ryood/TS_OD/eagle/TS-OD1_brd.png

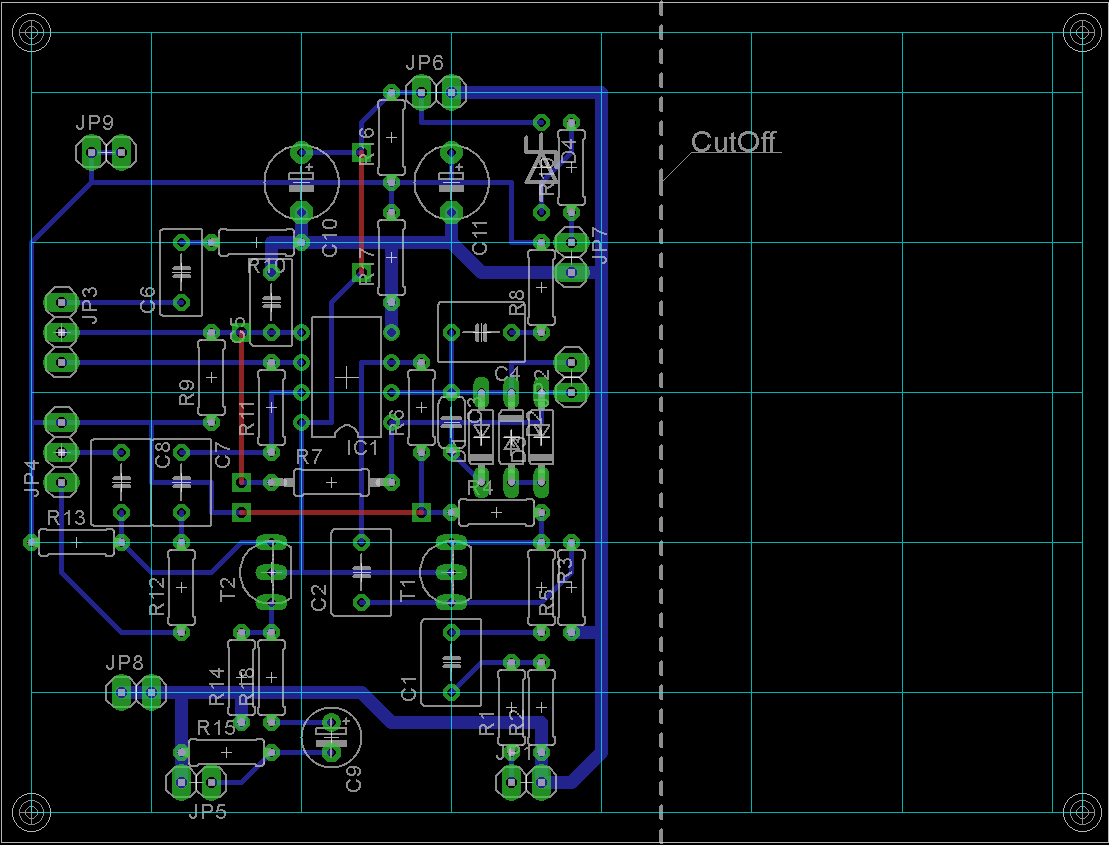
eagle/TS-OD1_brd.png
