ryood/TS_OD/eagle/TS-OD1_sch.png

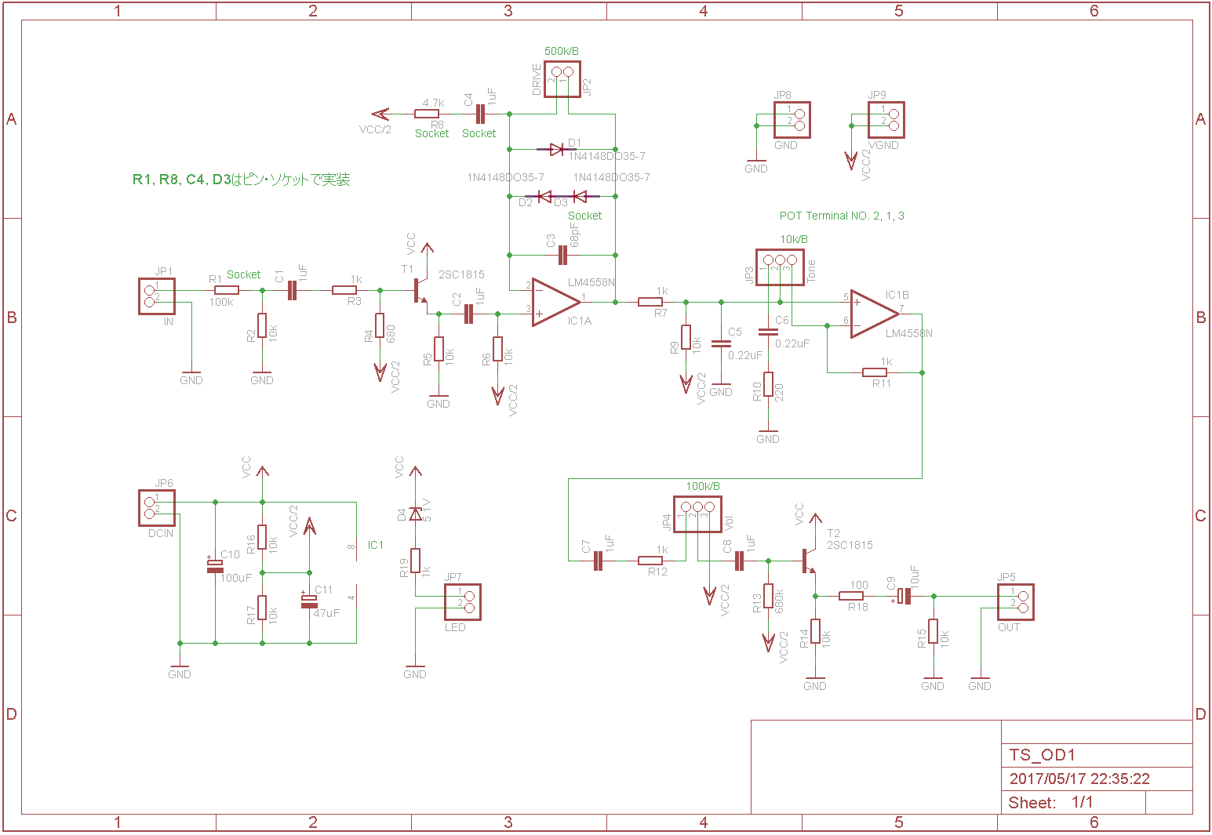
eagle/TS-OD1_sch.png
