ryood/TS_OD/fritzing/TS-OD1ケース内配線_ブレッドボード.png

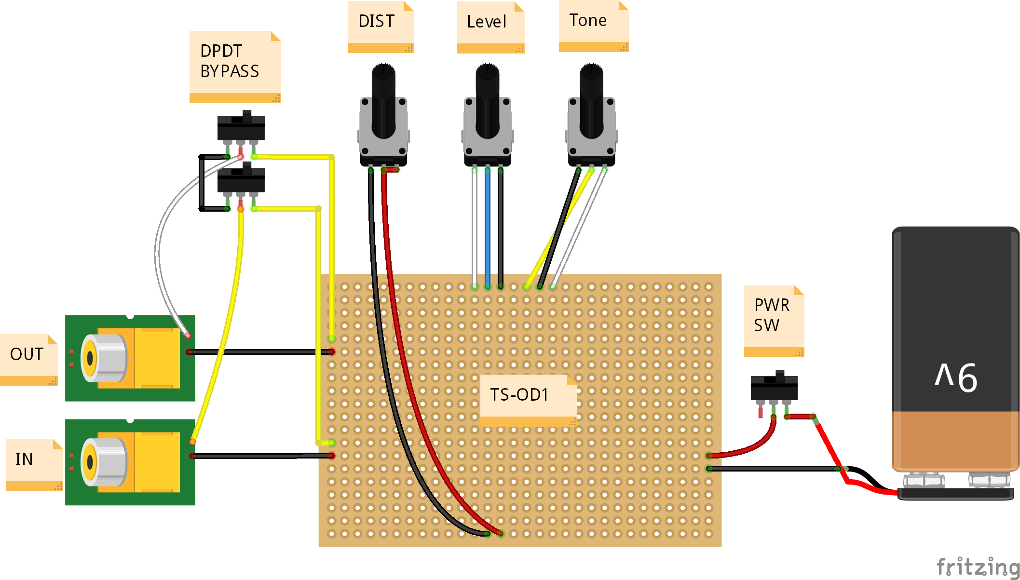
fritzing/TS-OD1ケース内配線_ブレッドボード.png
