ryood/TS_OD/fritzing/Tube_Screamer_Drive_ブレッドボード.png

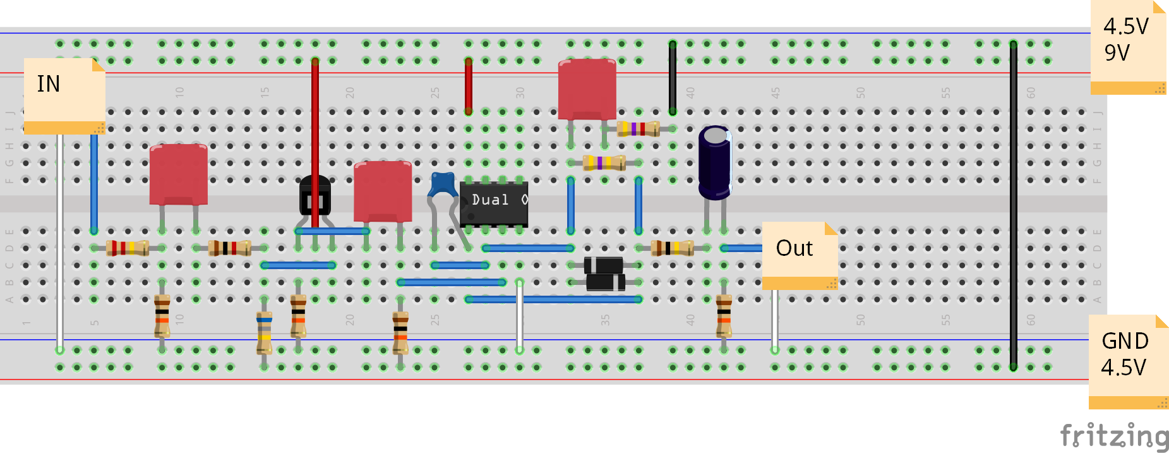
fritzing/Tube_Screamer_Drive_ブレッドボード.png
