ryood/TS_OD/fritzing/Tube_Screamer_Tone_ブレッドボード.png

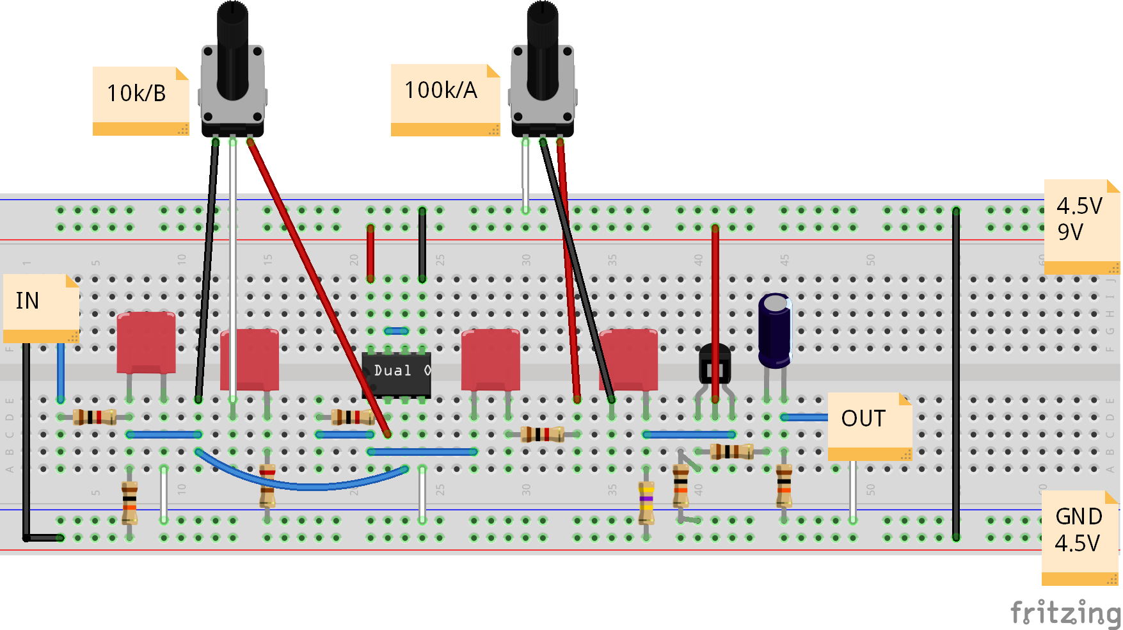
fritzing/Tube_Screamer_Tone_ブレッドボード.png
