ryood/TS_OD/ref/Ibanez_TS-808_cf.GIF

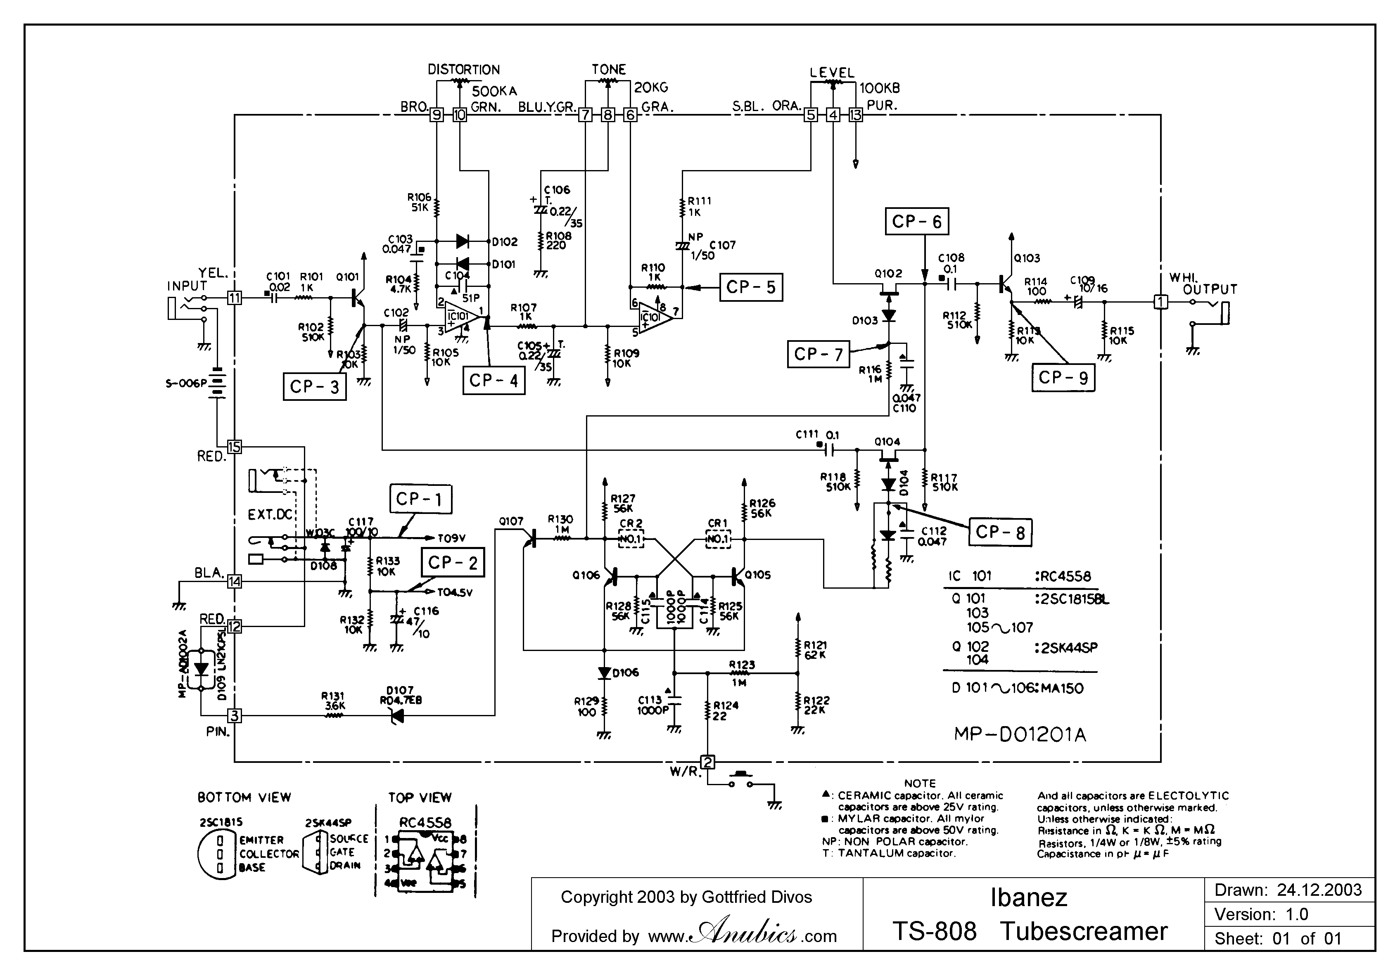
ref/Ibanez_TS-808_cf.GIF
