ryood/TS_OD/ref/OD1PG2.jpg

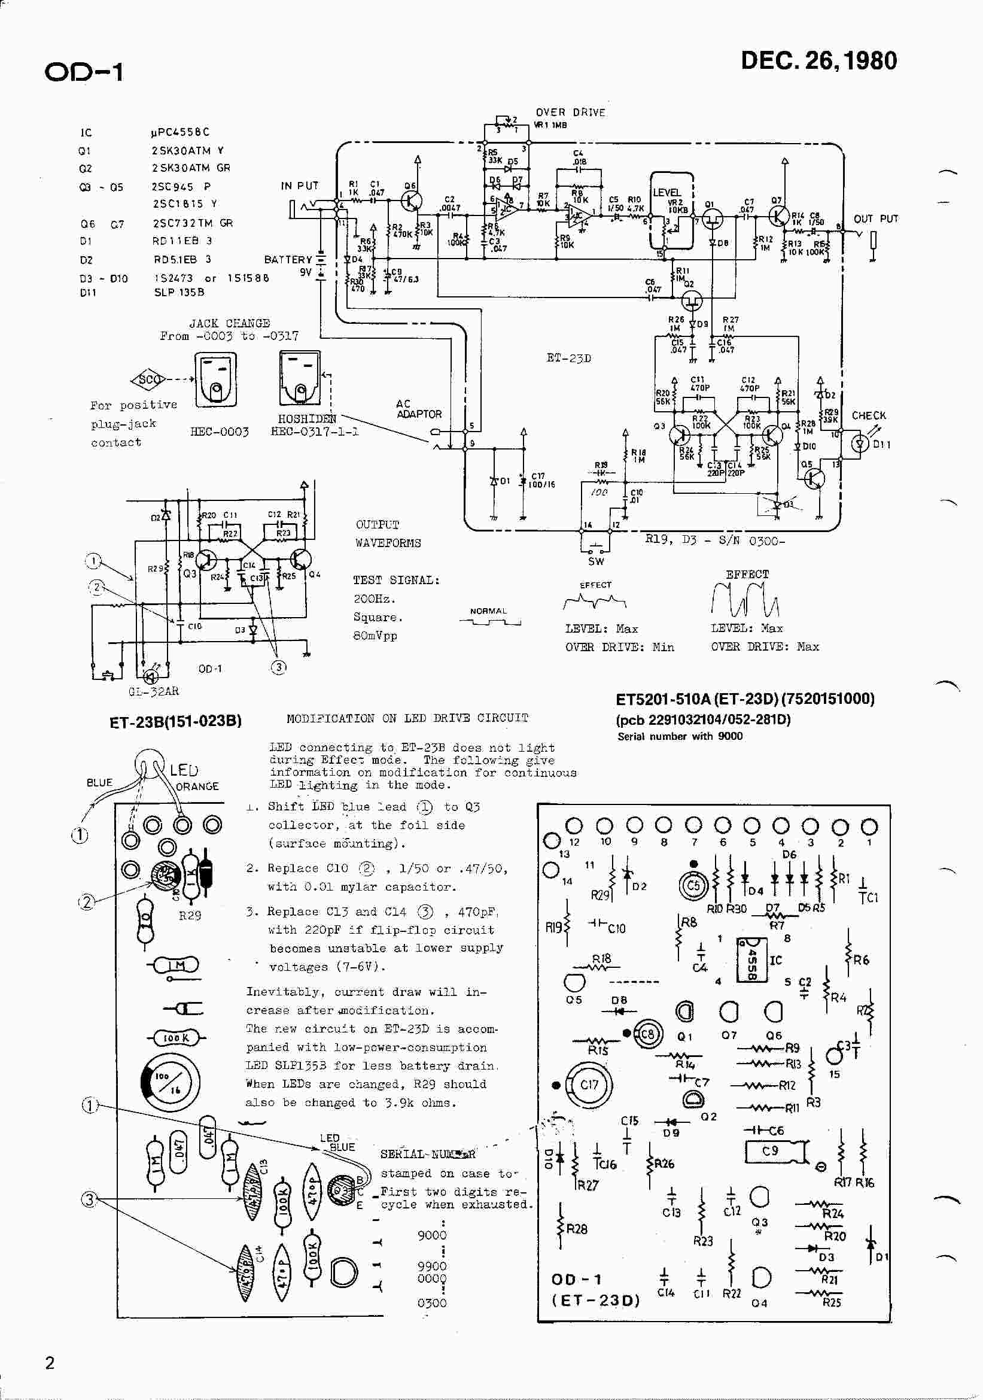
ref/OD1PG2.jpg
