ryood/TS_OD/ref/OD-808_sch.gif

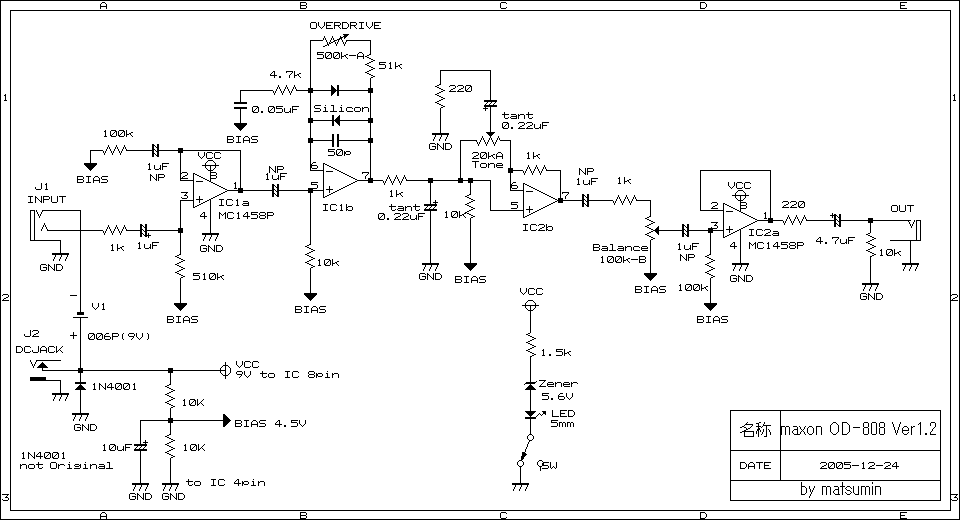
ref/OD-808_sch.gif
