ryood/TS_OD/ref/Rat.gif

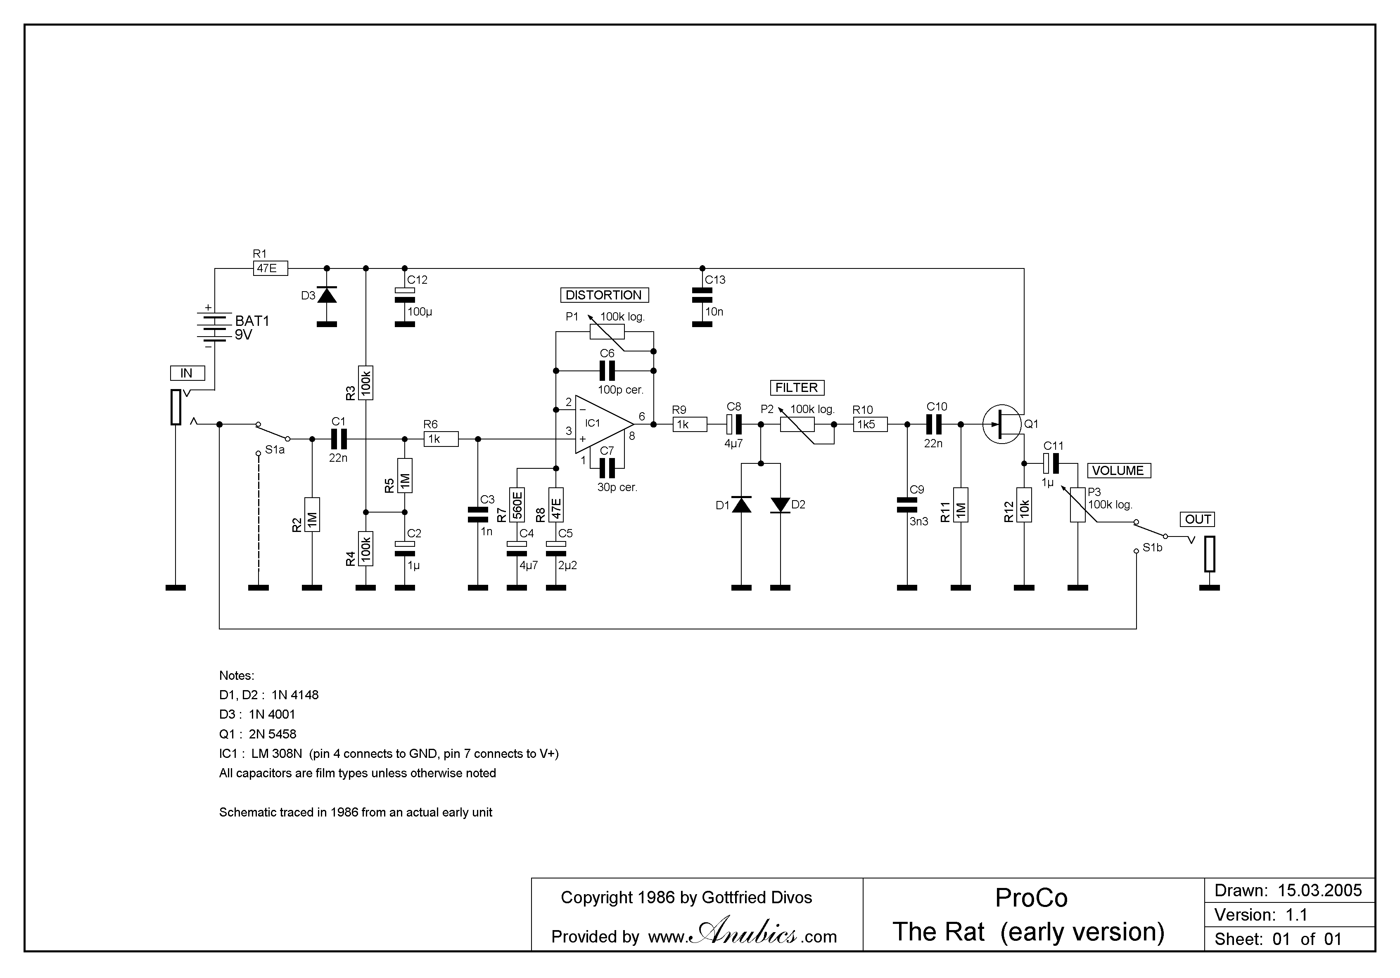
ref/Rat.gif
