ryood/TS_OD/(list of files, cad)

Other CAD files:
case/TS-OD1_PC_Case.dwg
