ryood/TS_OD/spice/OD-1_LEVEL.asc

C1: cap; 0.018uF
C2: cap; 1uF
C3: cap; 0.47uF
C4: cap; 1uF
Q1: npn
R1: res; 10k
R2: res; 10k
R3: res; 10k
R4: res; 4.7k
R5: res; {20k-Rlv}
R6: res; {Rlv}
R7: res; 1Meg
R8: res; 10k
R9: res; 1k
R10: res; 100k
U1: UniversalOpamp2
V1: voltage; SINE(0 1 1k); AC 1
V2: voltage; 4.5
V3: voltage; 4.5
Named nets: 4V5, 9V, 0, OUT, IN
;tran 2ms
.step param Rlv 1k 10k 2k
.ac oct 20 10 100k
