ryood/TS_OD/spice/proco-rat_2.asc

C1: cap; 22nF
C2: cap; 1nF
C3: cap; 100pF
C4: cap; 2.2uF
C5: cap; 4.7uF
C6: cap; 4.7uF
D1: diode; 1N914
D2: diode; 1N914
R1: res; 1Meg
R2: res; 1Meg
R3: res; 1k
R4: res; {Rdrive}
R5: res; 47
R6: res; 560
R7: res; 1k
U1: UniversalOpamp2
V1: voltage; SINE(0 10mV 1k); AC 10m
V2: voltage; 4.5V
V3: voltage; 4.5V
Named nets: VGND, 0, VCC, OUT, U1_OUT
.step param Rdrive 1k 100k 10k
;tran 0 100m 98m
.ac oct 20 10 100k
