ryood/TS_OD/spice/ProcoRAT_Tone.asc

C1: cap; 3.3nF
C2: cap; 22nF
C3: cap; 1uF
J1: njf; 2N5484
R1: res; {Rtone}
R2: res; 1.5k
R3: res; 1Meg
R4: res; 10k
R5: res; {100k-Rlv}
R6: res; {Rlv}
V1: voltage; SINE(0 1m 1k); AC 1
V2: voltage; 9
Named nets: 0, 9V, OUT
.param Rlv 50k
.step param Rtone 10k 100k 10k
;tran 0 100ms 97ms
.ac oct 20 10Hz 100kHz
