ryood/TS_OD/spice/TS_OD.asc

C1: cap; 1uF
C2: cap; 1uF
C3: cap; 47pF
C4: cap; 1uF
C5: cap; 0.22uF
C6: cap; 0.1uF
C7: cap; 0.22uF
C8: cap; 1uF
C9: cap; 10uF
C10: cap; 100uF
C11: cap; 47uF
D1: diode
D2: diode
D3: diode
Q1: npn
Q2: npn
R1: res; 100k
R2: res; 10k
R3: res; 1k
R4: res; 680k
R5: res; 10k
R6: res; 10k
R7: res; 1k
R8: res; 10k
R9: res; {Rtone}
R10: res; {10k-Rtone}
R11: res; 220
R12: res; 1k
R13: res; 1k
R14: res; {100k-Rlv}
R15: res; {Rlv}
R16: res; 510k
R17: res; 10k
R18: res; 100
R19: res; 10k
R20: res; {Rdrive}
R21: res; 4.7k
R22: res; 10k
R23: res; 10k
U1: opamp2; NJM4558_SUB
U2: opamp2; NJM4558_SUB
V1: voltage; PULSE(0 1 0 10m 0 0 10m); AC 1
V2: voltage; 9
Named nets: 4V5, 0, 9V, Output, Input
Tone
Volume
.include mylib\\NJM4558.lib
.tran 0 100m 70m
;ac oct 20 10 100k
;.step param Rtone list 1k 5k 9k
;.step param Rlv 10k 90k 10k
.param Rtone 9k
.param Rlv 99k
;.param Rdrive 400k
.step param Rdrive 100k 500k 100k
