ryood/TS_OD/spice/FoxeyLady.asc

C1: cap; 0.1uF
C2: cap; 47uF
C3: cap; 0.1uF
C4: cap; 4.7uF
C5: cap; 0.0033uF
C6: cap; 0.0033uF
Q1: npn
Q2: npn
R1: res; 1Meg
R2: res; 470k
R3: res; 47k
R4: res; 22k
R5: res; 680
R6: res; 470k
R7: res; 47k
R8: res; 47k
R9: res; 680
R10: res; 22k
R11: res; {100k-Rfuzz}
R12: res; {Rfuzz}
R13: res; {Rvol}
R14: res; {100k-Rvol}
V1: voltage; 9V
V2: voltage; SINE(0 50m 1k); AC 1
Named nets: 0, VCC, IN, OUT
.step param Rfuzz list 10k 20k 50k 80k 99k
.param Rvol 75k
.tran 0 100m 98m
;ac oct 20 10 100k
