ryood/TS_OD/spice/FY-2.asc

C1: cap; 0.047uF
C2: cap; 0.001uF
C3: cap; 0.047uF
C4: cap; 0.047uF
C5: cap; 0.0033uF
C6: cap; 0.001uF
C7: cap; 0.1uF
C8: cap; 0.0022uF
Q1: npn; 2SC1815
Q2: npn; 2SC1815
R1: res; 2.2Meg
R2: res; 22k
R3: res; 1.2Meg
R4: res; 47k
R5: res; 100k
R6: res; {50k-Rfuzz}
R7: res; {Rfuzz}
R8: res; 10k
R9: res; 15k
R10: res; {50k-Rvol}
R11: res; {Rvol}
V1: voltage; 9V
V2: voltage; SINE(0 20m 1k); AC 1
Named nets: 0, OUT, IN, VCC
.param Rvol 45k
.step param Rfuzz list 1k 10k 25k 40k 49k
.tran 0 100m 98m
;ac oct 20 10 100k
