ryood/TS_OD/spice/Input_Voltage.asc

C1: cap; 0.022uF
C2: cap; 1uF
Q1: npn
R1: res; 1Meg
R2: res; 1k
R3: res; 10k
R4: res; 10k
R22: res; {R}
V1: voltage; SINE(0 50m 1k); AC 1
V2: voltage; 4.5V
V3: voltage; 4.5V
Named nets: VCC, Input, OUT, 0, VEE, VBin, VEout
.tran 0 100m 98m
;ac oct 10 10 100k
.step param R list 1k 10k 50k 100k 500k 1Meg
