ryood/TS_OD/spice/OD-1_2.asc

C1: cap; 0.022uF
C2: cap; 1uF
C3: cap; 51pF
C4: cap; 0.047uF
C5: cap; 0.22uF
C6: cap; 0.1uF
C7: cap; 0.22uF
C8: cap; 1uF
C9: cap; 10uF
C10: cap; 100uF
C11: cap; 47uF
D1: diode; 1N914
D2: diode; 1N914
D3: diode; 1N914
Q1: npn
Q2: npn
R1: res; 1.5Meg
R2: res; 1k
R3: res; 10k
R4: res; 10k
R5: res; {Rdrive}
R6: res; 4.7k
R7: res; 1k
R8: res; 10k
R9: res; 10k
R10: res; 10k
R11: res; 220
R12: res; 1k
R13: res; 1k
R14: res; 10k
R15: res; 90k
R16: res; 510k
R17: res; 10k
R18: res; 100
R19: res; 10k
R20: res; 10k
R21: res; 10k
R22: res; 510k
U1: opamp2; NJM4558_SUB
U2: opamp2; NJM4558_SUB
V1: voltage; SINE(0 20m 1k); AC 1
V2: voltage; 9V
Named nets: 0, 4V5, 9V, Output, Input, DriveOut
Drive
Tone
Volume
Power
.include mylib\\NJM4558.lib
.step param Rdrive list 50k 100k 250k 350k 500k
.tran 0 100m 98m
;ac oct 10 10 100k
;.step param Rtone list 1k 5k 10k 15k 19k
