ryood/TS_OD/spice/proco-rat_1Vin.asc

C1: cap; 22nF
C2: cap; 1nF
C3: cap; 100pF
C4: cap; 2.2uF
C5: cap; 4.7uF
C6: cap; 4.7uF
D1: diode; 1N914
D2: diode; 1N914
R1: res; 1Meg
R2: res; 1Meg
R3: res; 1k
R4: res; {Rdrive}
R5: res; 47
R6: res; 560
R7: res; 1k
U1: UniversalOpamp2
V1: voltage; SINE(0 0.1V 1k); AC 1
V2: voltage; 4.5V
V3: voltage; 4.5V
Named nets: VGND, 0, VCC, OUT, 4V5, IN
.step param Rdrive list 1k 2k 5k 10k 20k
.tran 0 100m 98m
;ac oct 20 1 100k
