ryood/TS_OD/spice/Tube_Screamer_Drive.asc

C1: cap; 1uF
C2: cap; 1uF
C3: cap; 68pF
C4: cap; 1uF
C5: cap; 10uF
D1: diode; 1N4148
D2: diode; 1N4148
Q1: npn
R1: res; 10k
R2: res; 1k
R3: res; 10k
R4: res; 10k
R5: res; {Rdrive}
R6: res; 4.7k
R7: res; 10k
R8: res; 100k
R9: res; 220k
R22: res; 680k
U1: opamp2; NJM4558_SUB
V1: voltage; SINE(0 0.5 100); AC 1
V2: voltage; 4.5V
V3: voltage; 4.5V
Named nets: 0, 4V5, 9V, Input, OUT
Drive
.include mylib\\NJM4558.lib
.step param Rdrive list 50k 100k 250k 350k 500k
.tran 0 100m 80m
;ac oct 20 10 100k
