ryood/TS_OD/spice/Tube_Screamer_Tone.asc

C5: cap; 0.22uF
C6: cap; 0.1uF
C7: cap; 0.22uF
C8: cap; 1uF
C9: cap; 10uF
Q2: npn
R7: res; 1k
R8: res; 10k
R9: res; {Rtone}
R10: res; {20k-Rtone}
R11: res; 220
R12: res; 1k
R13: res; 1k
R14: res; {100k-Rlv}
R15: res; {Rlv}
R16: res; 510k
R17: res; 10k
R18: res; 100
R19: res; 10k
U2: opamp2; NJM4558_SUB
V1: voltage; PULSE(0 1 0 10m 0 0 10m); AC 1
V2: voltage; 4.5V
V3: voltage; 4.5V
Named nets: 4V5, 0, 9V, Output, Input
Tone
Volume
.include mylib\\NJM4558.lib
.tran 0 100m 70m
;ac oct 20 10 100k
.step param Rtone list 1k 5k 10k 15k 19k
;.step param Rlv 10k 90k 10k
.param Rtone 19k
.param Rlv 99k
