ryood/TS_OD/spice/TubeScreamer_ToneCircuit.asc

C1: cap; 0.22uF
C2: cap; 0.22uF
C3: cap; 0.22uF
R1: res; 1k
R2: res; 20k
R3: res; 220
R4: res; 1k
R5: res; 20k
R6: res; 220
R7: res; 1k
R8: res; 18k
R9: res; 220
R10: res; 2k
U1: UniversalOpamp2
U2: UniversalOpamp2
U3: UniversalOpamp2
V1: voltage; SINE(0 1 1k); AC 1
V2: voltage; SINE(0 1 1k); AC 1
V3: voltage; 4.5
V4: voltage; 4.5
V5: voltage; SINE(0 1 1k); AC 1
Named nets: 0, 4V5, OUT1, OUT2, 9V, OUT3
.ac oct 20 10 100k
;tran 5ms
