ryood/TS_OD/(list of files, drawings)

Other design files:
fritzing/TS-OD1ケース内配線.fzz
fritzing/TS_OD.fzz
fritzing/Tube_Screamer_808.fzz
fritzing/Tube_Screamer_Drive.fzz
fritzing/Tube_Screamer_Tone.fzz
