ryood/TS_OD/(commit log)

2017-05-15 change eagle files' name from TS_OD to TS_OD1
    [TS_OD.fzz, TS_OD1.brd, TS_OD1.sch]
2017-07-03 Update: eagle files Add: drawing of the case
    [TS-OD1 テスト表_20170517.xlsx, TS-OD1_PC_Case.dwg, TS-OD1ケース内配線.fzz, TS_OD1.brd, TS_OD1.sch]
